MattCarvajal/safeSight/website/assets/img/team/wei_Profile.jpg

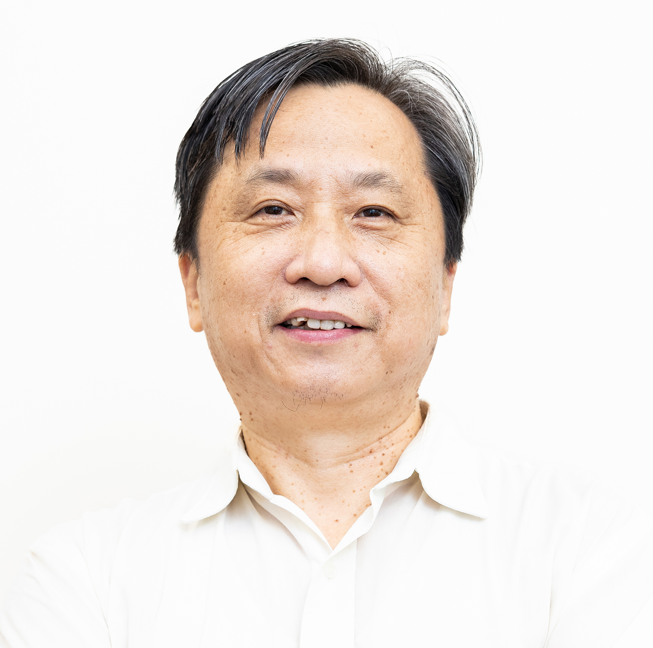
website/assets/img/team/wei_Profile.jpg
