MattCarvajal/safeSight/website/assets/img/team/wasfy_Profile.jpg

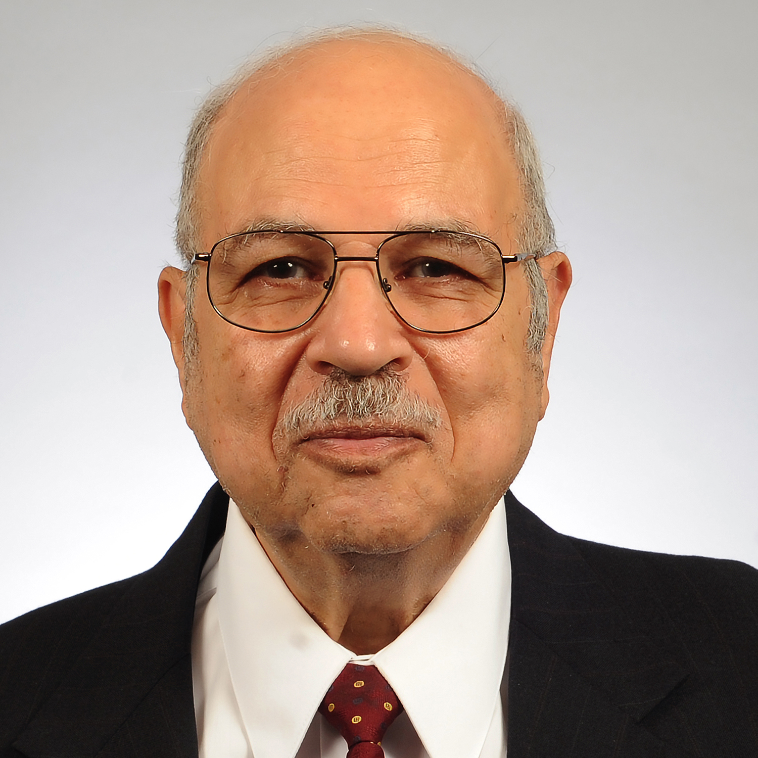
website/assets/img/team/wasfy_Profile.jpg
