MattCarvajal/safeSight/README.md

# safeSight
SafeSight SD project sp-fall
