MattCarvajal/safeSight/website/assets/img/team/bertProfile.jpg

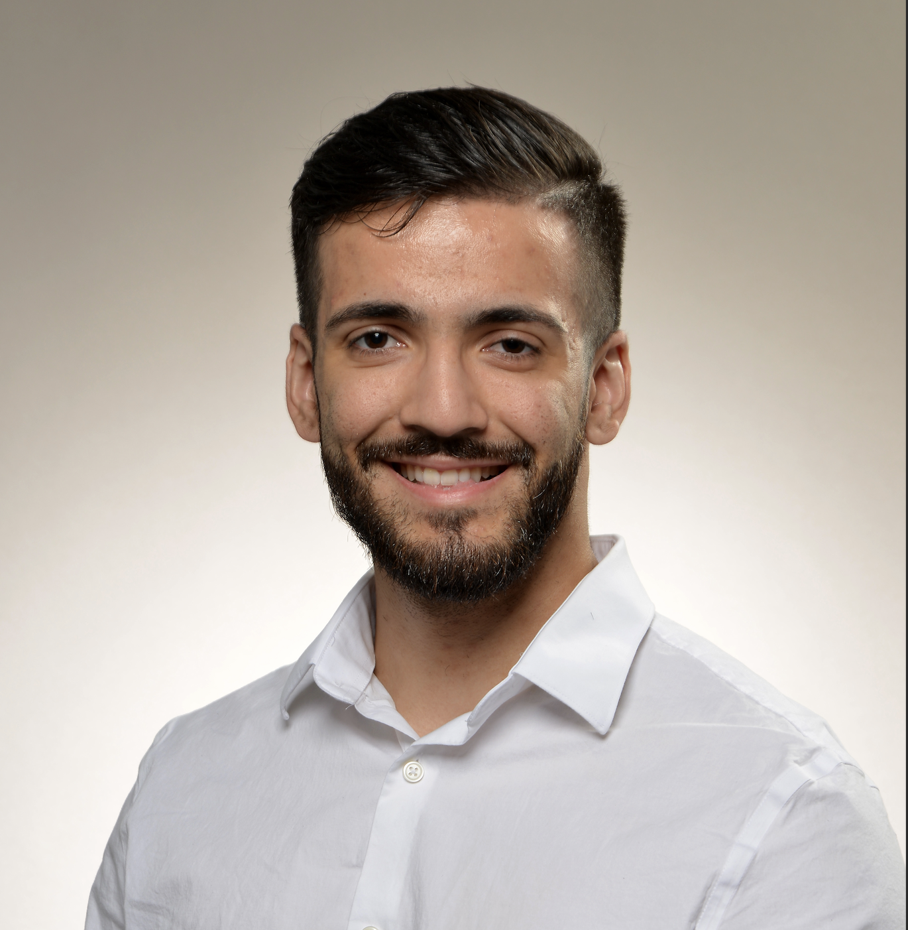
website/assets/img/team/bertProfile.jpg
