MattCarvajal/safeSight/website/assets/img/team/Chan.jpg

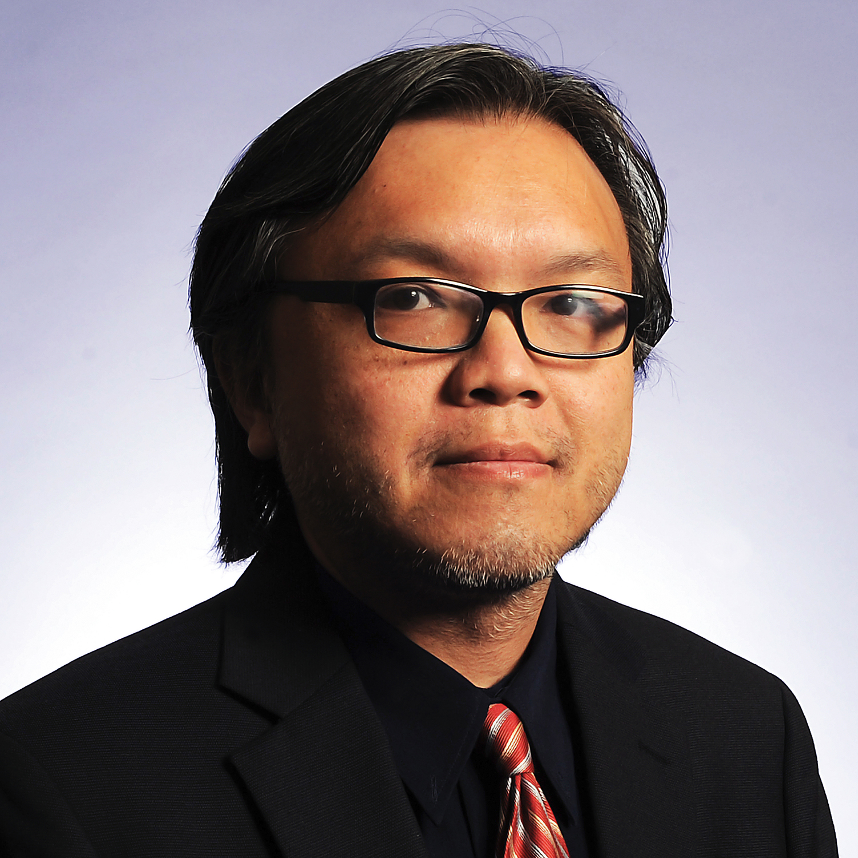
website/assets/img/team/Chan.jpg
