MattCarvajal/safeSight/website/assets/img/team/das_profile.jpg

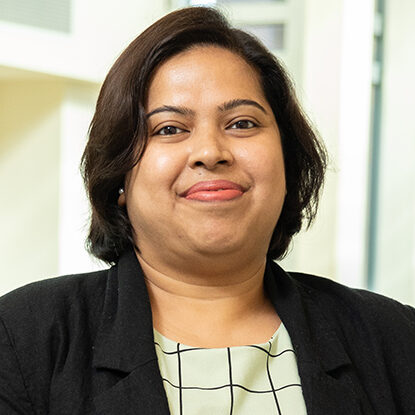
website/assets/img/team/das_profile.jpg
