MattCarvajal/safeSight/website/assets/img/team/mahyarProfile.jpg

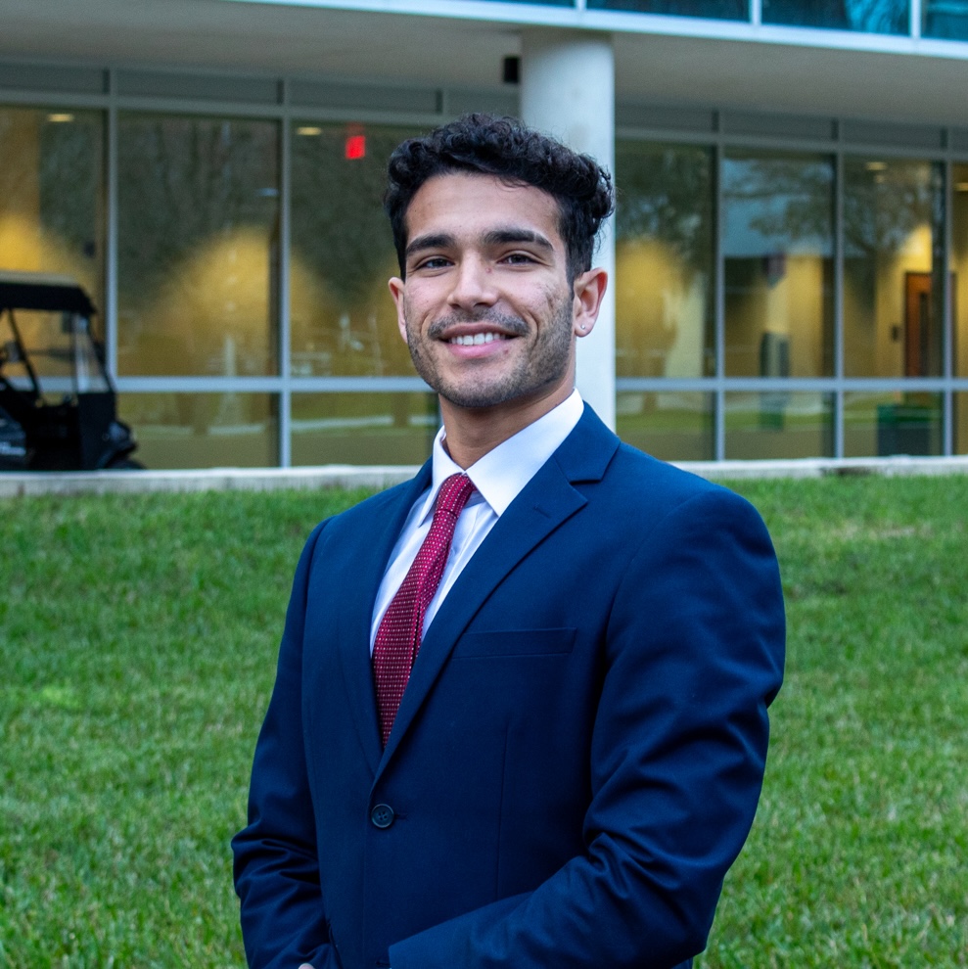
website/assets/img/team/mahyarProfile.jpg
