MattCarvajal/safeSight/website/assets/img/team/mattprofile.jpg

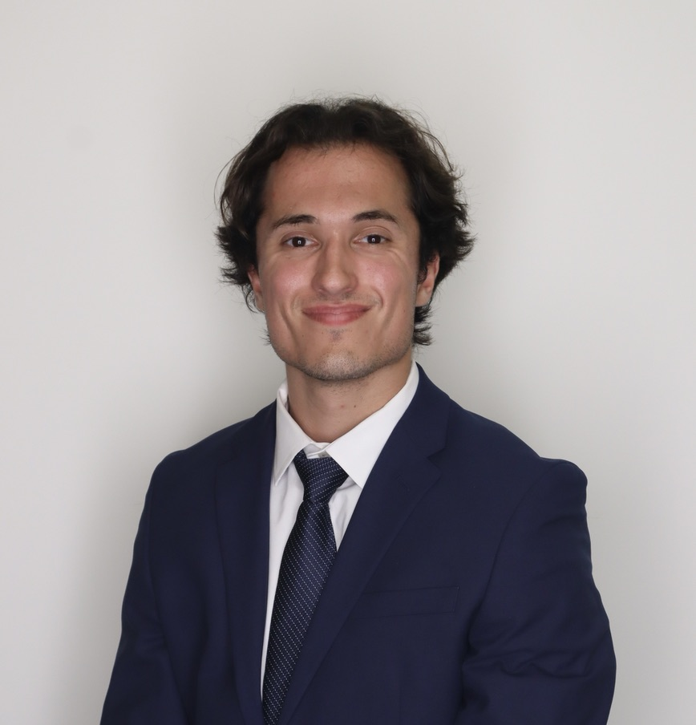
website/assets/img/team/mattprofile.jpg
