MattCarvajal/safeSight/website/assets/img/team/reza_Profile.jpg

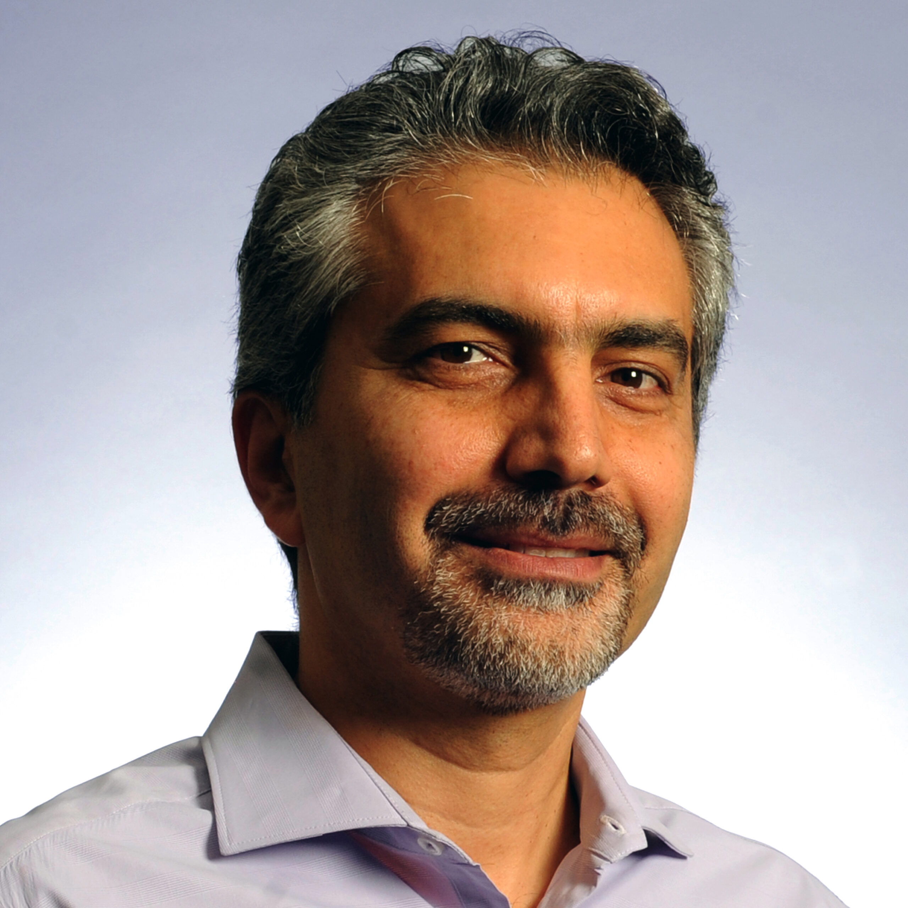
website/assets/img/team/reza_Profile.jpg
