MattCarvajal/safeSight/website/assets/projectFiles/d&c_Pic.jpg

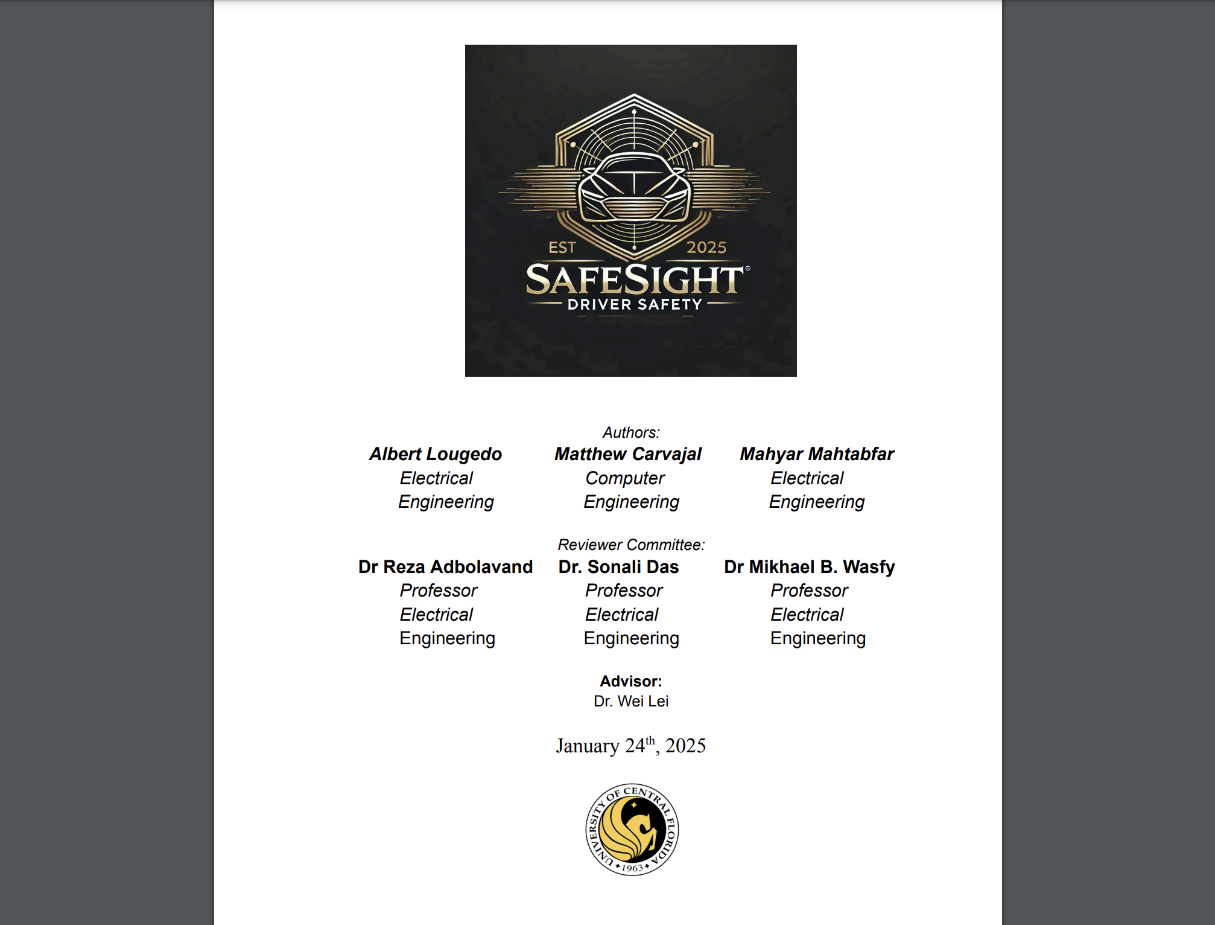
website/assets/projectFiles/d&c_Pic.jpg
