MattCarvajal/safeSight/website/assets/projectFiles/Demo_pic.jpg

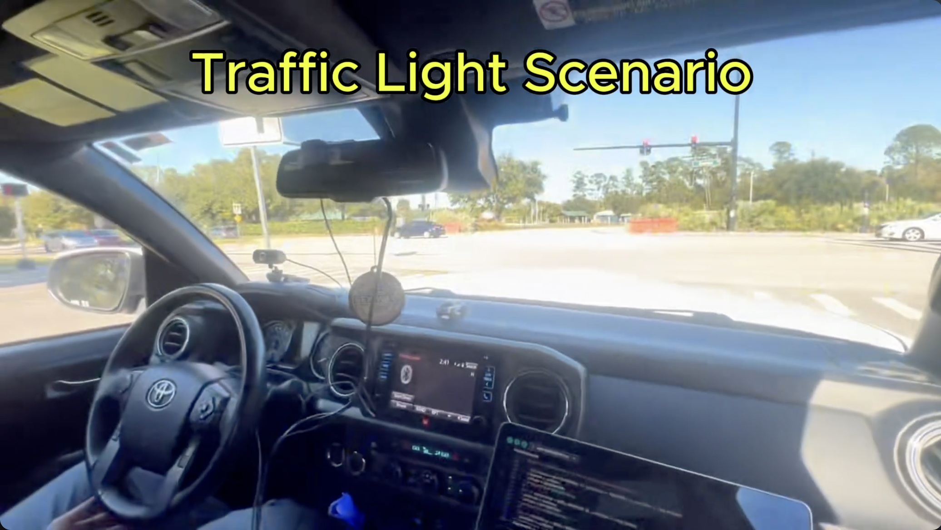
website/assets/projectFiles/Demo_pic.jpg
