MattCarvajal/safeSight/website/assets/projectFiles/demoVideo.jpg

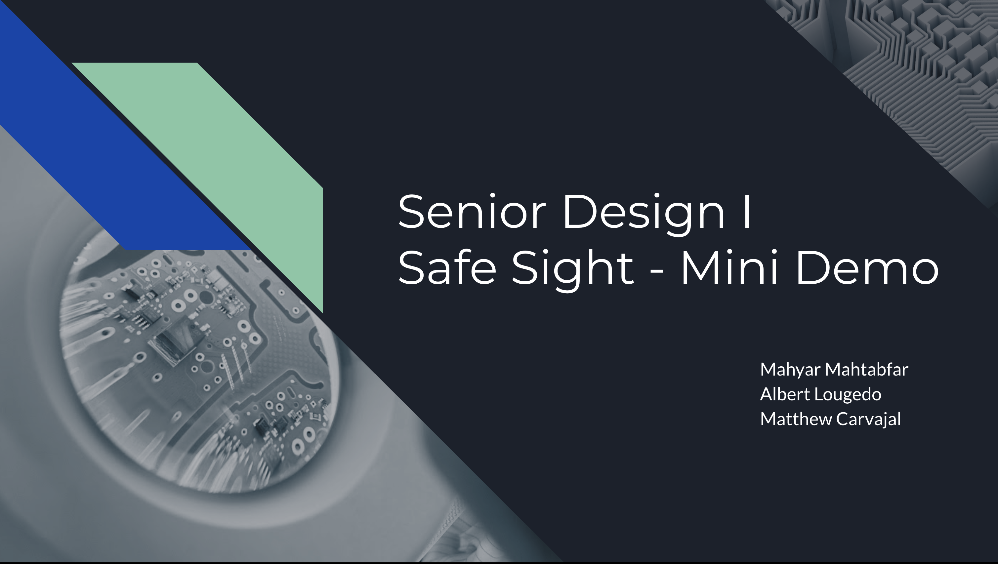
website/assets/projectFiles/demoVideo.jpg
