MattCarvajal/safeSight/website/assets/projectFiles/Midterm_SC.jpg

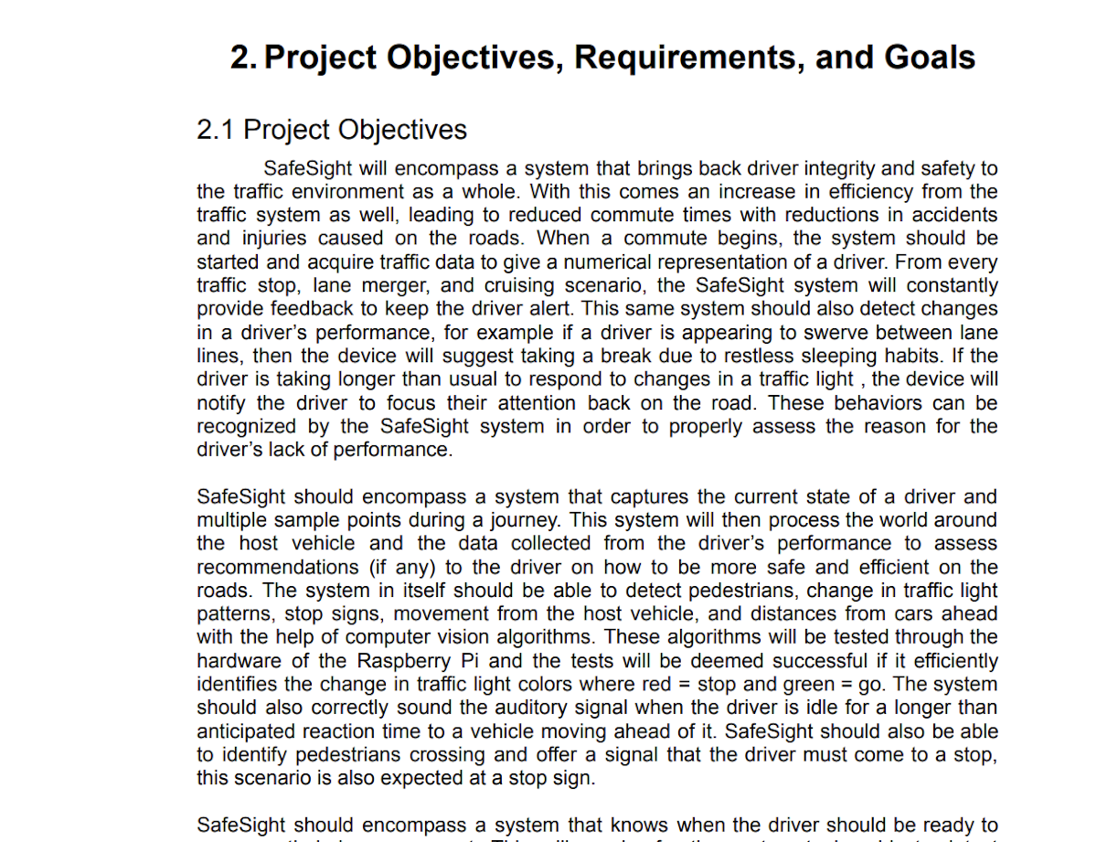
website/assets/projectFiles/Midterm_SC.jpg
