MattCarvajal/safeSight/website/assets/projectFiles/MidtermPic.jpg

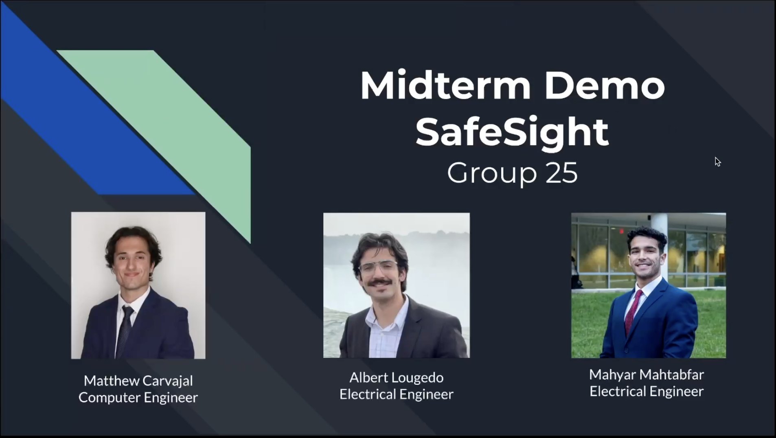
website/assets/projectFiles/MidtermPic.jpg
