MattCarvajal/safeSight/website/assets/projectFiles/SD2 paper.jpg

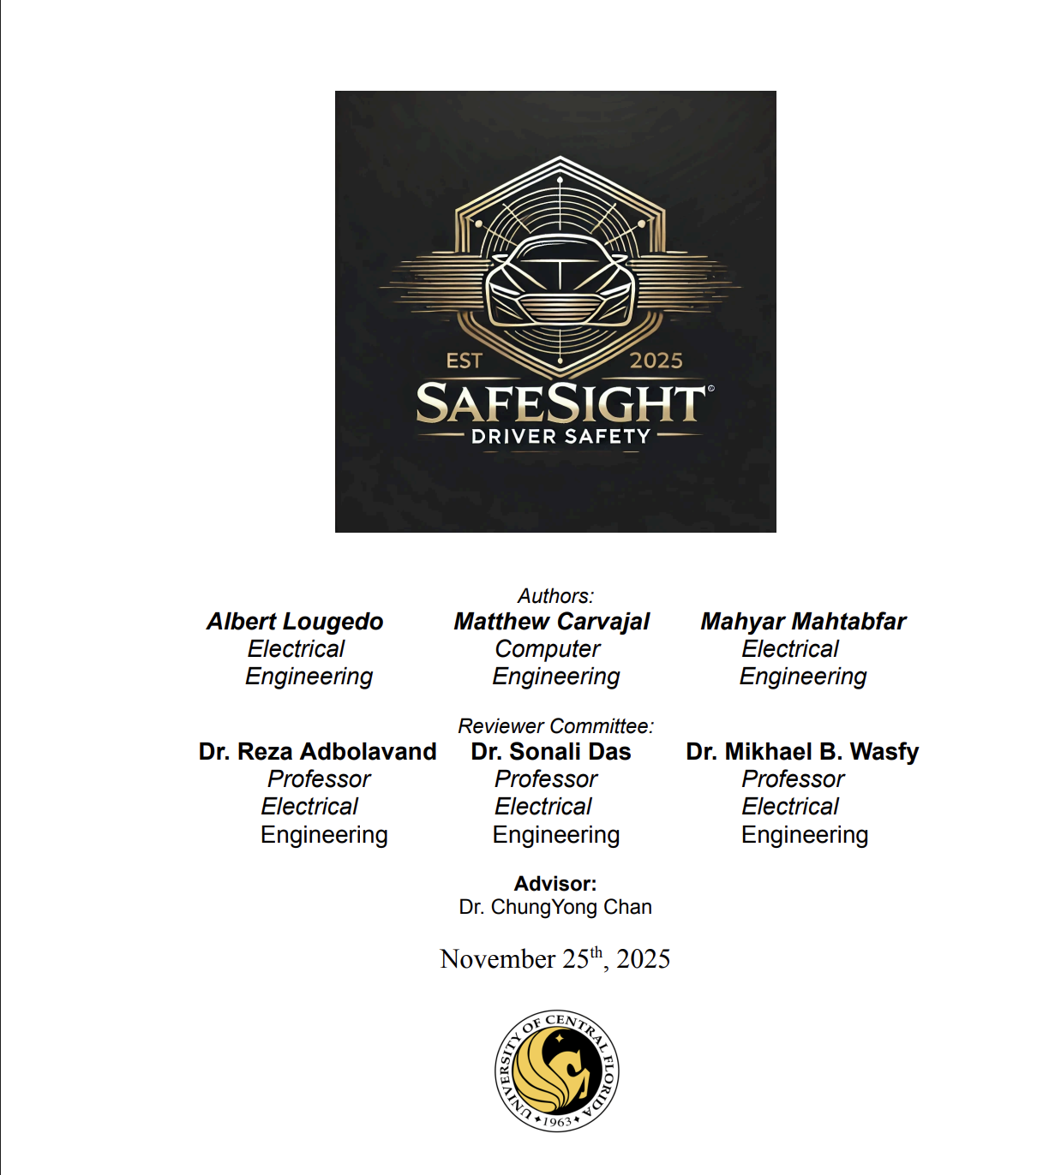
website/assets/projectFiles/SD2 paper.jpg
