MattCarvajal/safeSight/website/assets/projectFiles/SS_CF_PIC.jpg

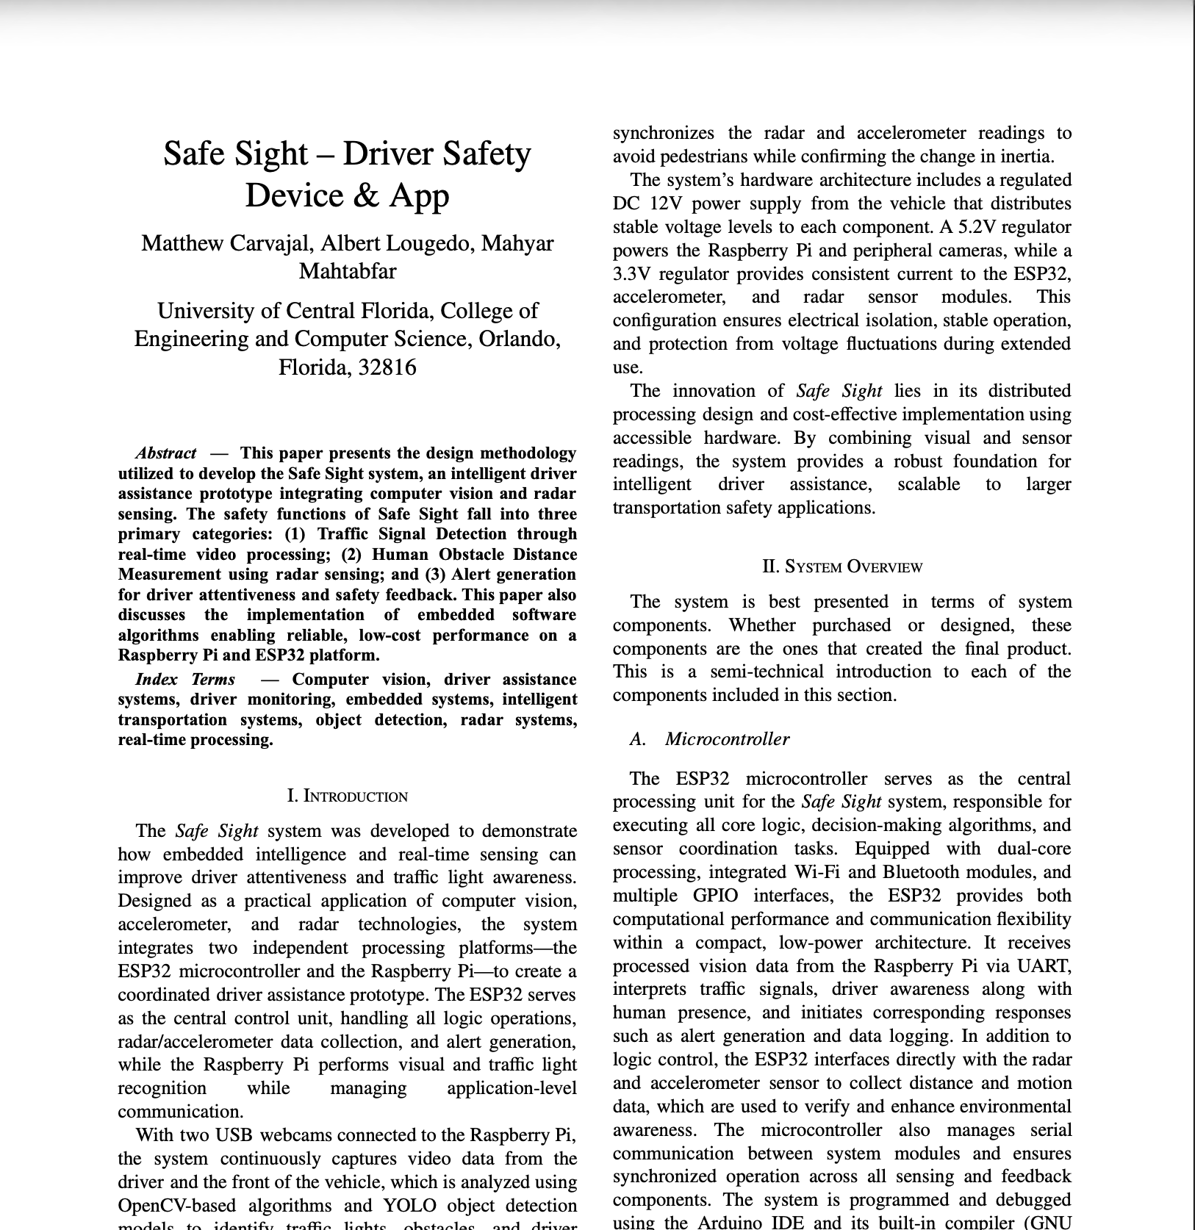
website/assets/projectFiles/SS_CF_PIC.jpg
