MattCarvajal/safeSight/(commit log)

2025-09-03 added arduinoCode into repo MC
2025-09-15 changed up the live camera view for a photo gallery view MC
2025-10-26 FInal esp32 code
2025-11-07 fixed the no face detected line MC
    [parallelCV.py]
2025-11-17 adjusted for drivers face MC
